ChenLR/SIT/PCB/main_board/main_brd.brd

## EAGLE design PCB/main_board/main_brd.brd (2019-06-15)

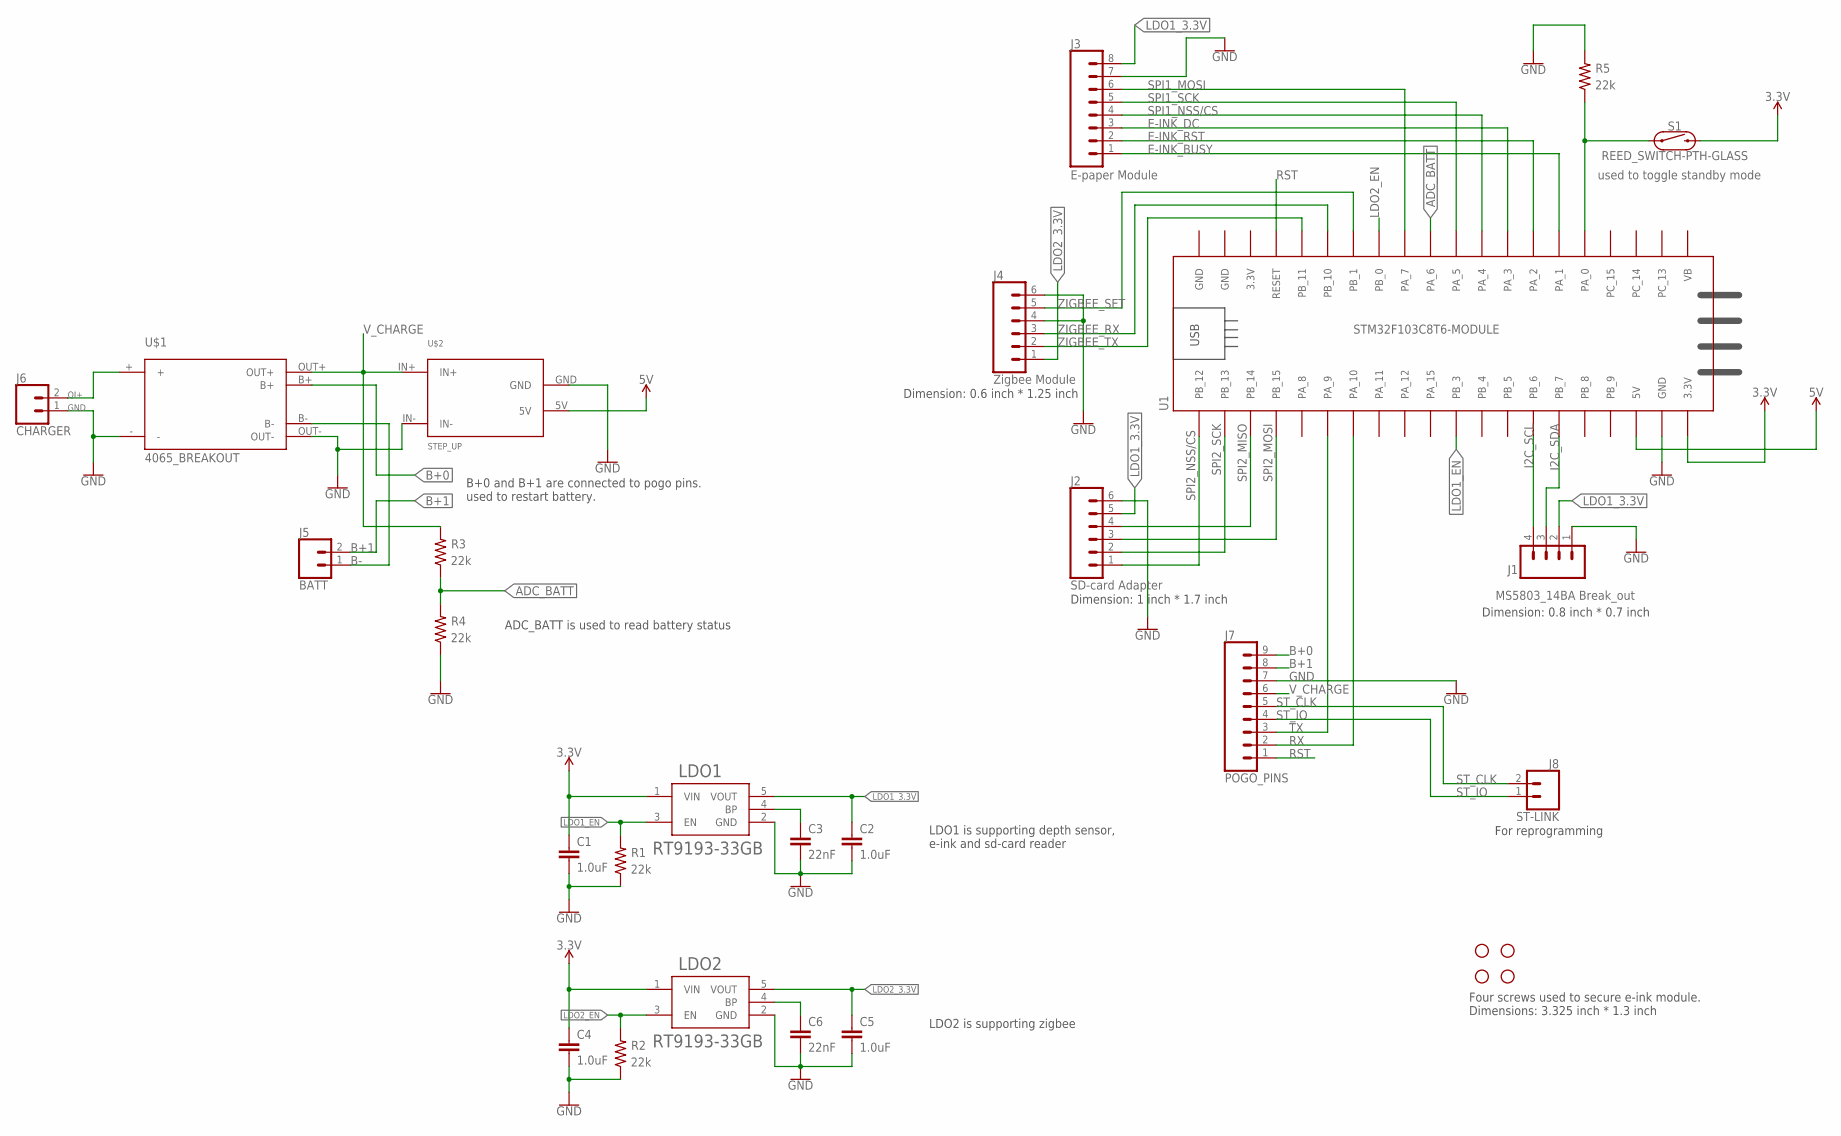
[picture p1: schematic main_brd.sch]

Parts:
C1, C2, C4, C5: 1.0uF; 0603
C3, C6: 22nF; 0603
H1, H2, H3, H4: STAND-OFFTIGHT; STAND-OFF-TIGHT
J1: MS5803_14BA Break_out; 1X04
J2: SD-card Adapter; 1X06
J3: E-paper Module; 1X08
J4: Zigbee Module; 1X06
J5: BATT; 1X02
J6: CHARGER; 1X02
J7: POGO_PINS; 1X09
J8: ST-LINK; 1X02
LDO1, LDO2: RT9193-33GB; SOT94P279X129-5N
R1, R2, R3, R4, R5: 22k; 0603
S1: REED_SWITCH-PTH-GLASS; REED_SWITCH_GLASS
U1: STM32F103C8T6-MODULE
U$1: 4065_BREAKOUT; CHARGE_MODULE
U$2: STEP_UP; STEP_UP_99_69

Connections:
3.3V: C1.1, C4.1, LDO1.1 (VIN), LDO2.1 (VIN), S1.P$2 (2), U1.3.3V_1 (3.3V)
5V: U1.5V, U$2.5V
ADC_BATT: R3.1, R4.2, U1.PA_6
B+0: J7.9, U$1.B+
B+1: J5.2, J7.8
B-: J5.1, U$1.B-
E-INK_BUSY: J3.1, U1.PA_1
E-INK_DC: J3.3, U1.PA_3
E-INK_RST: J3.2, U1.PA_2
GND: C1.2, C2.2, C3.2, C4.2, C5.2, C6.2, J1.1, J2.6, J3.7, J4.4, J4.6, J6.1, J7.7, LDO1.2 (GND), LDO2.2 (GND), R1.1, R2.1, R4.1, R5.2, U1.GND_1 (GND), U1.GND_3 (GND), U$1.-, U$1.OUT-, U$2.GND, U$2.IN-
I2C_SCL: J1.4, U1.PB_6
I2C_SDA: J1.3, U1.PB_7
LDO1_3.3V: C2.1, J1.2, J2.5, J3.8, LDO1.5 (VOUT)
LDO1_EN: LDO1.3 (EN), R1.2, U1.PB_3
LDO2_3.3V: C5.1, J4.1, LDO2.5 (VOUT)
LDO2_EN: LDO2.3 (EN), R2.2, U1.PB_0
unnamed: C6.1, LDO2.4 (BP)
unnamed: C3.1, LDO1.4 (BP)
unnamed: R5.1, S1.P$1 (1), U1.PA_0
QI+: J6.2, U$1.+
RST: J7.1, U1.RESET
RX: J7.2, U1.PA_10
SPI1_MOSI: J3.6, U1.PA_7
SPI1_NSS/CS: J3.4, U1.PA_4
SPI1_SCK: J3.5, U1.PA_5
SPI2_MISO: J2.4, U1.PB_14
SPI2_MOSI: J2.3, U1.PB_15
SPI2_NSS/CS: J2.1, U1.PB_12
SPI2_SCK: J2.2, U1.PB_13
ST_CLK: J7.5, J8.2
ST_IO: J7.4, J8.1
TX: J7.3, U1.PA_9
V_CHARGE: J7.6, R3.2, U$1.OUT+, U$2.IN+
ZIGBEE_RX: J4.3, U1.PB_10
ZIGBEE_SET: J4.5, U1.PB_1
ZIGBEE_TX: J4.2, U1.PB_11

Notes on the sheet:
E-paper Module
used to toggle standby mode
For reprogramming
LDO1 is supporting depth sensor, e-ink and sd-card reader
LDO2 is supporting zigbee
ADC_BATT is used to read battery status
B+0 and B+1 are connected to pogo pins. used to restart battery.
Four screws used to secure e-ink module. Dimensions: 3.325 inch * 1.3 inch
Dimension: 1 inch * 1.7 inch
Dimension: 0.8 inch * 0.7 inch
Dimension: 0.6 inch * 1.25 inch

Board: 2 copper layers, 29 parts (1 on the bottom side), 36 nets, no tracks yet.
