ChenLR/SIT/PCB/MS5803/MS5803-14BA_Breakout_v10.brd

## EAGLE design PCB/MS5803/MS5803-14BA_Breakout_v10.brd (2019-06-11)

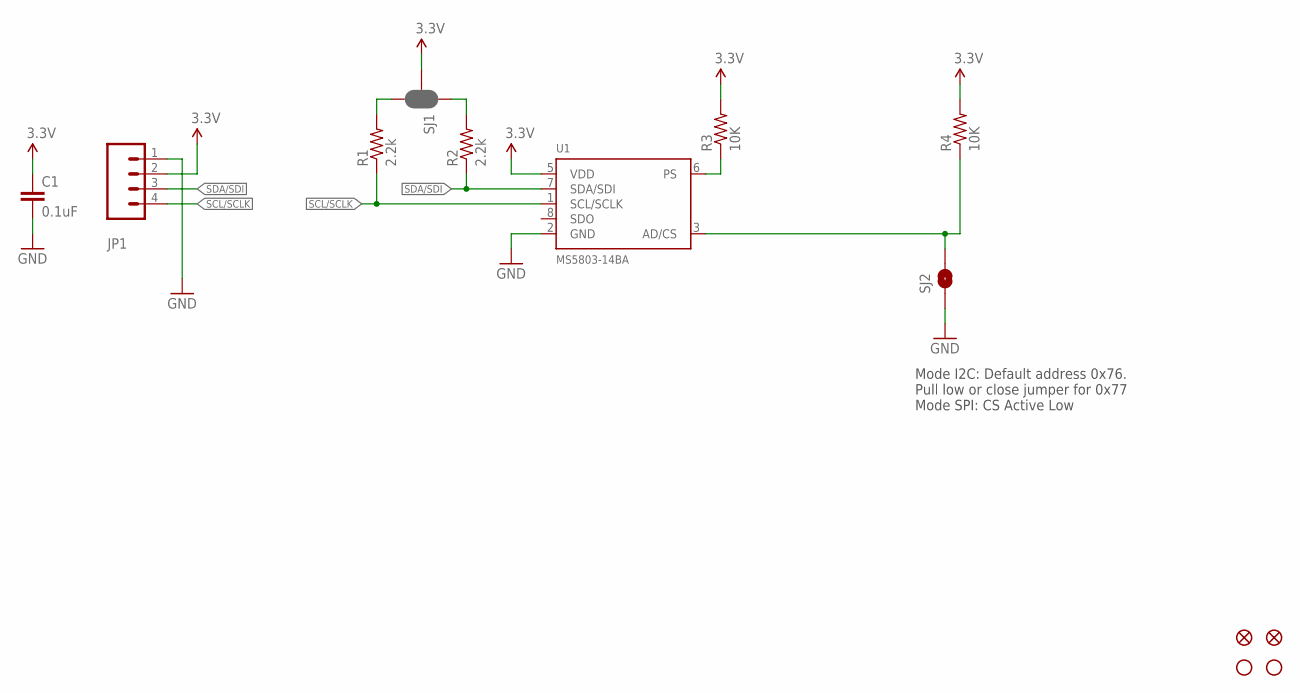
[picture p2: schematic MS5803-14BA_Breakout_v10.sch]

Parts:
C1: 0.1uF; 0603-CAP
FID1, FID2: FIDUCIAL1X2; FIDUCIAL-1X2
JP1: CONN_04PTH; 1X04
R1, R2: 2.2k; 0603-RES
R3, R4: 10K; 0603-RES
SJ1: JUMPER-PAD-3-NC_BY_PASTE; PAD-JUMPER-3-NC_BY_PASTE_YES_SILK_FULL_BOX
SJ2: SOLDERJUMPERNO; SJ_2S-NO
STANDOFF1, STANDOFF2: STAND-OFFTIGHT; STAND-OFF-TIGHT
U1: MS5803-14BA; MS5803

Connections:
3.3V: C1.1, JP1.2, R3.2, R4.2, SJ1.2, U1.5 (VDD)
AD/CS: R4.1, SJ2.2, U1.3 (AD/CS)
GND: C1.2, JP1.1, SJ2.1, U1.2 (GND)
unnamed: R1.2, SJ1.3
unnamed: R2.2, SJ1.1
PS: R3.1, U1.6 (PS)
SCL/SCLK: JP1.4, R1.1, U1.1 (SCL/SCLK)
SDA/SDI: JP1.3, R2.1, U1.7 (SDA/SDI)

Notes on the sheet:
Mode I2C: Default address 0x76. Pull low or close jumper for 0x77 Mode SPI: CS Active Low

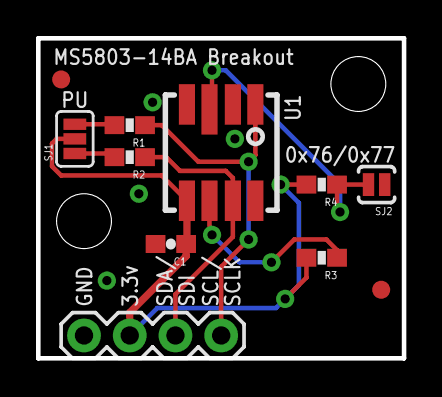
[picture p3: board MS5803-14BA_Breakout_v10.brd from above]

Board: 2 copper layers, 20.3 x 17.8 mm, 13 parts (0 on the bottom side), 8 nets.
