ChenLR/SIT/(commit log)

2019-04-24 add first led demo
2019-04-26 add usart and i2c demo
2019-05-01 rtc module with bug
    [main.c]
2019-05-03 fix led project setting
2019-05-04 redirect printf
2019-05-04 add led display
2019-05-07 add adc, comment RTC
2019-05-08 change led logic for standby
2019-05-08 update pin map for eink
2019-05-16 B&W eink module driver finished
2019-05-29 remove redundant drivers for V0.2
2019-05-31 change adc pin, change main function, use two usart ports
2019-06-01 support sw4stm32
    [smart-tile-v0.2 Run.cfg]
2019-06-03 receive from stm32
2019-06-05 v0.15 for 2nd prototype
2019-06-07 fix protocol issue with length of 0x0D for stm32
    [main.c]
2019-06-10 add RTC in stm32
2019-06-11 Add PCB files
2019-06-11 upload PCB files for depth sensor breakout
    [MS5803-14BA_Breakout_v10.brd, MS5803-14BA_Breakout_v10.sch]
2019-06-11 add main board pcb files
